arachnidlabs/reload-pro/pcb/pcb render.png

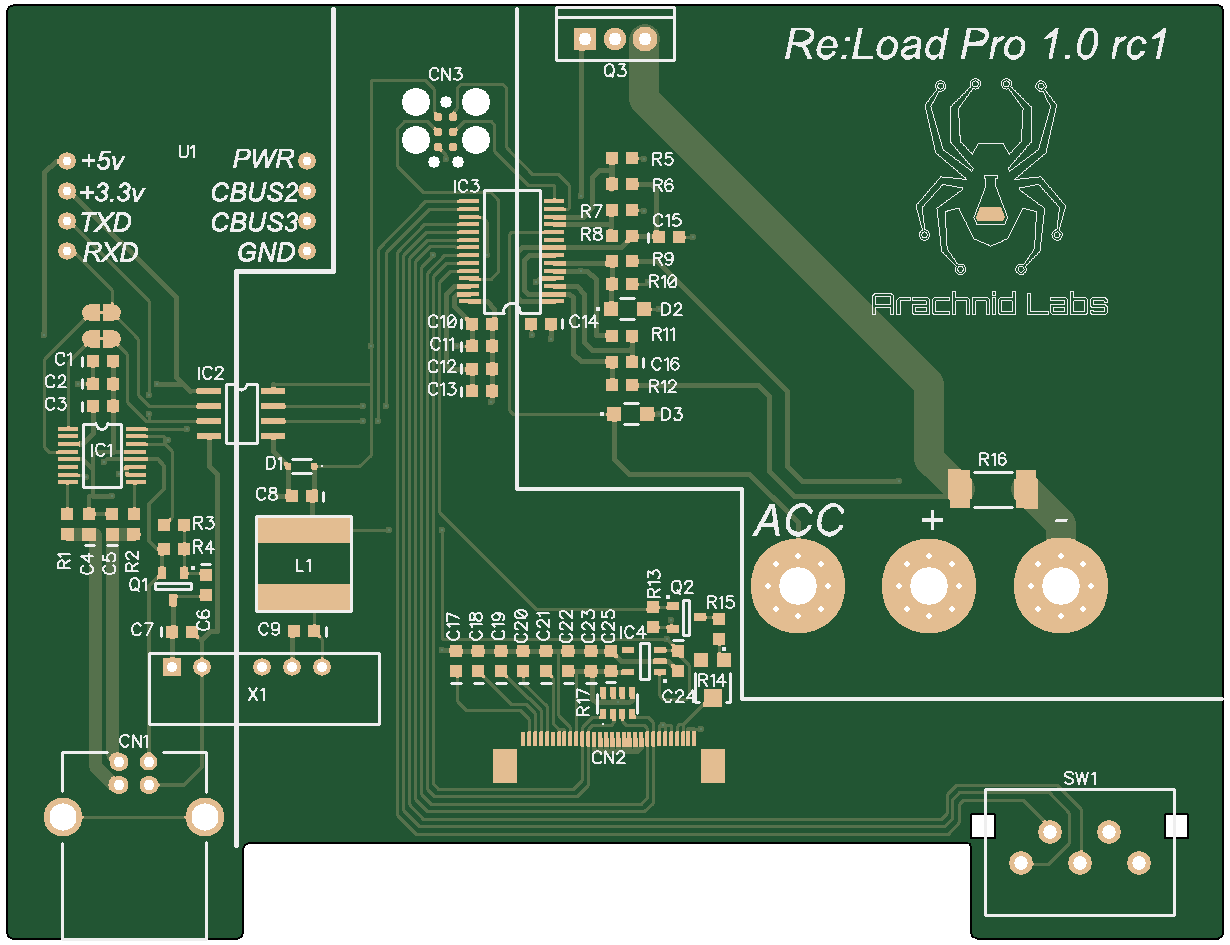
pcb/pcb render.png
