arachnidlabs/reload-pro/models/Fan Plate.dxf

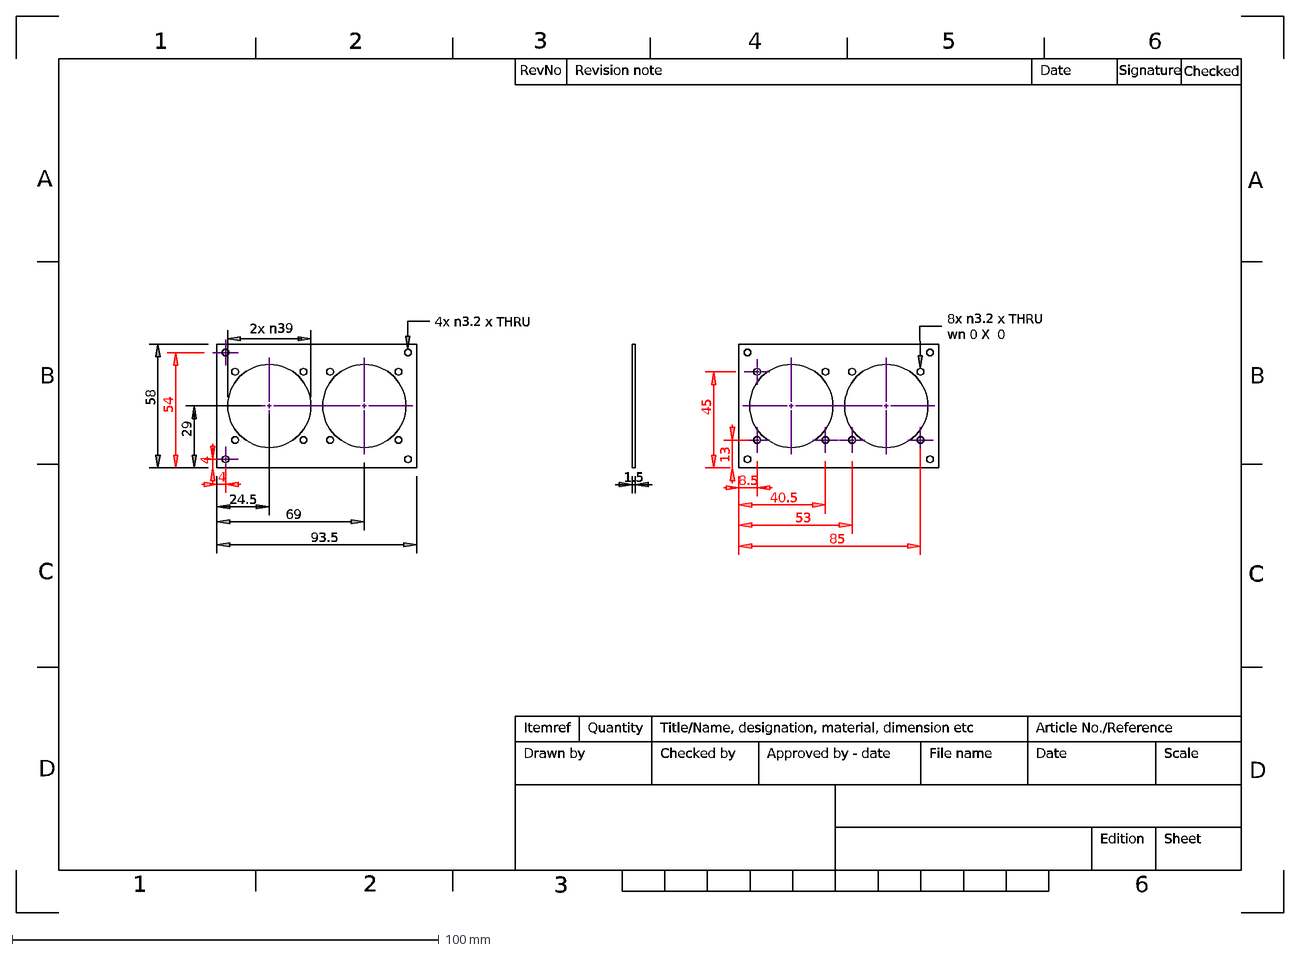
[picture p2: CAD file, 2015-01-16]
models/Fan Plate.dxf
4
29
54
58
24.5
69
93.5
1.5
8.5
40.5
53
85
13
45
1
Approved by - date
5
C
Edition
6
Date
B
3
Scale
A
D
File name
Sheet
Article No./Reference
Signature
Checked
Itemref
2
Quantity
Title/Name, designation, material, dimension etc
Revision note
Drawn by
RevNo
Checked by
