arachnidlabs/reload-pro/pcb/board outline.dxf

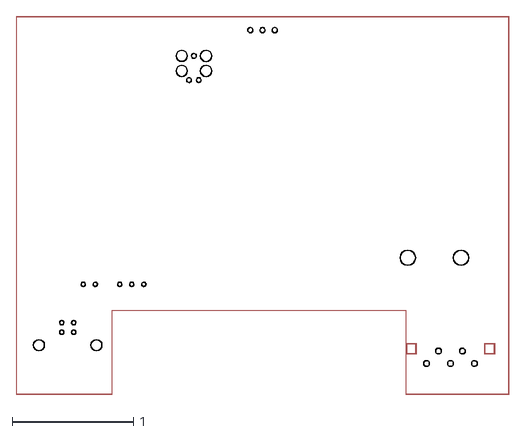
[picture p3: CAD file, 2014-01-12]
pcb/board outline.dxf
4.06 x 3.12
