arachnidlabs/reload-pro/models/AEH087.dxf

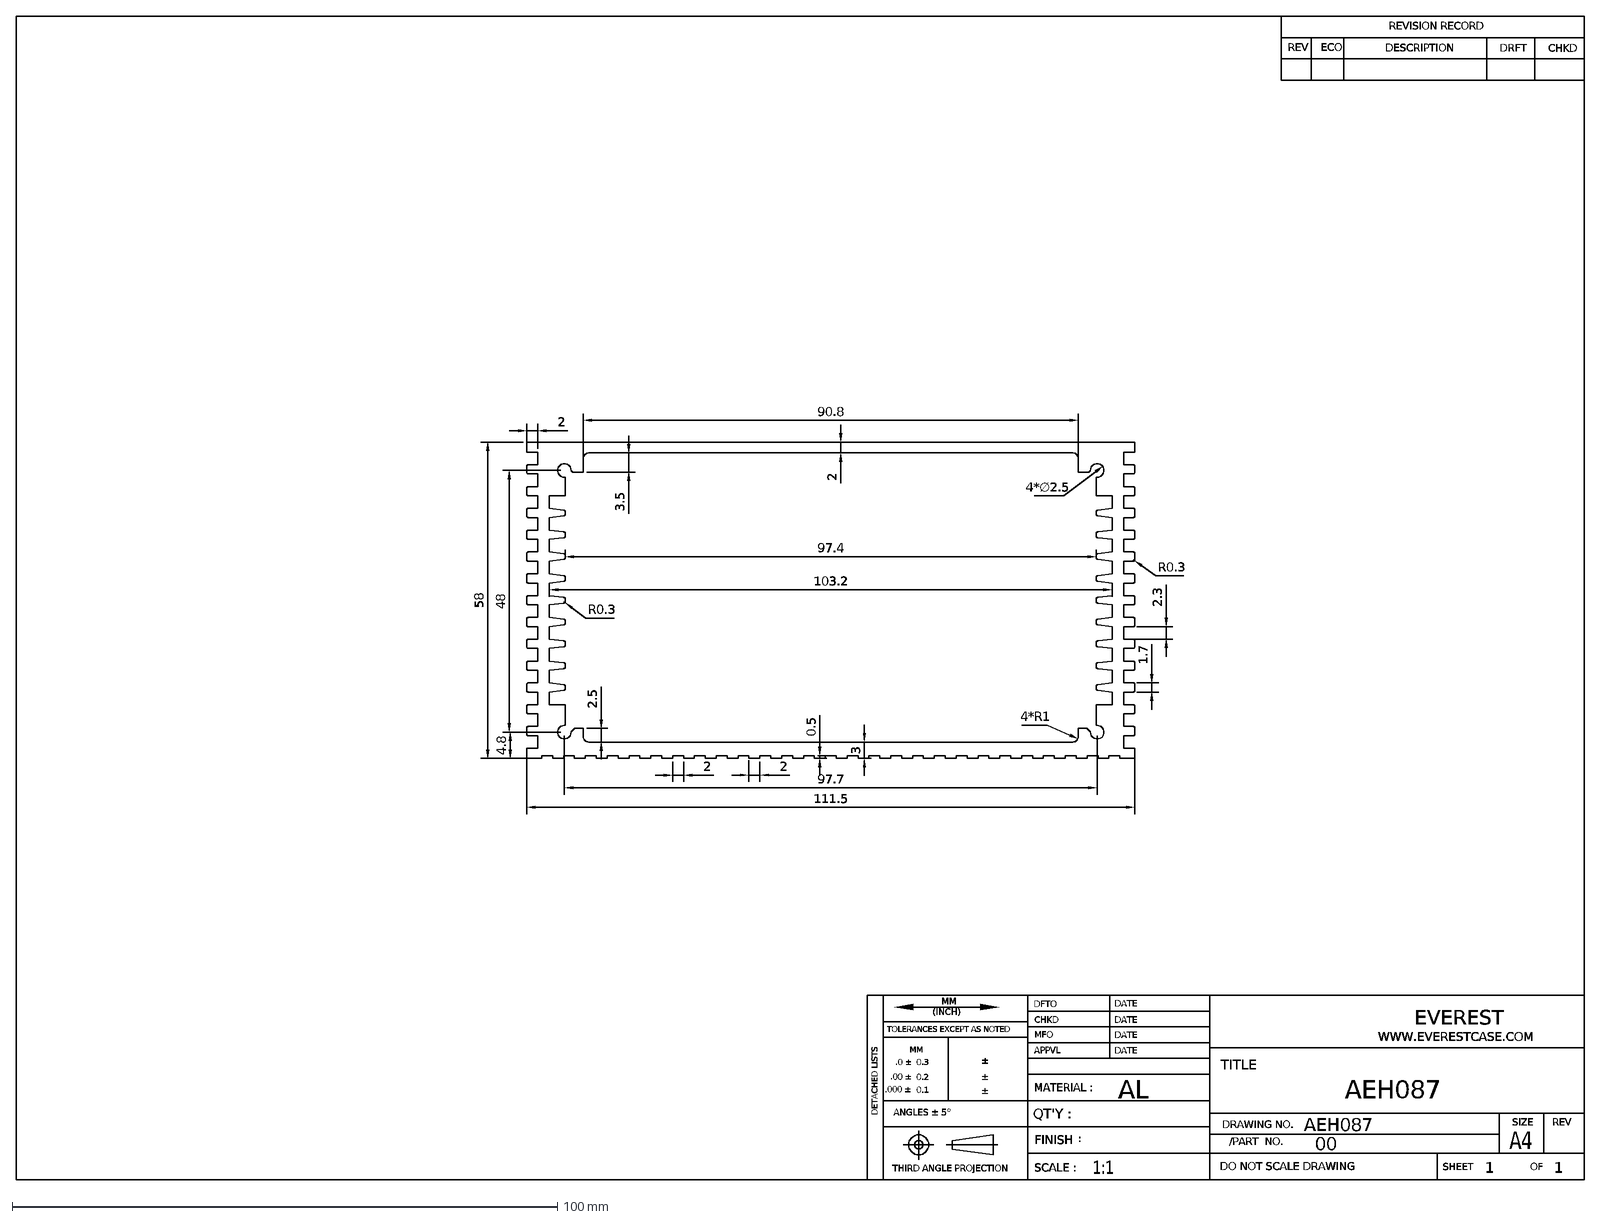
[picture p4: CAD file, 2014-05-03]
models/AEH087.dxf
ECO
REV
DESCRIPTION
CHKD
DRFT
REVISION RECORD
SIZE
A4
DATE
AEH087
00
TITLE
AL
/PART NO.
DRAWING NO.
EVEREST
WWW.EVERESTCASE.COM
SHEET
OF
DO NOT SCALE DRAWING
MM
DFTO
±
MATERIAL :
QT'Y :
APPVL
MFO
FINISH
:
.00 ±
0.2
DETACHED LISTS
0.1
.000 ±
0.3
.0 ±
ANGLES ± 5°
TOLERANCES EXCEPT AS NOTED
(INCH)
THIRD ANGLE PROJECTION
SCALE :
2
97.7
111.5
4*R1
4*∅2.5
R0.3
0.5
3
1.7
2.3
4.8
48
58
90.8
3.5
2.5
97.4
103.2
