arachnidlabs/reload-pro/models/Reload Pro Heatsink.dxf

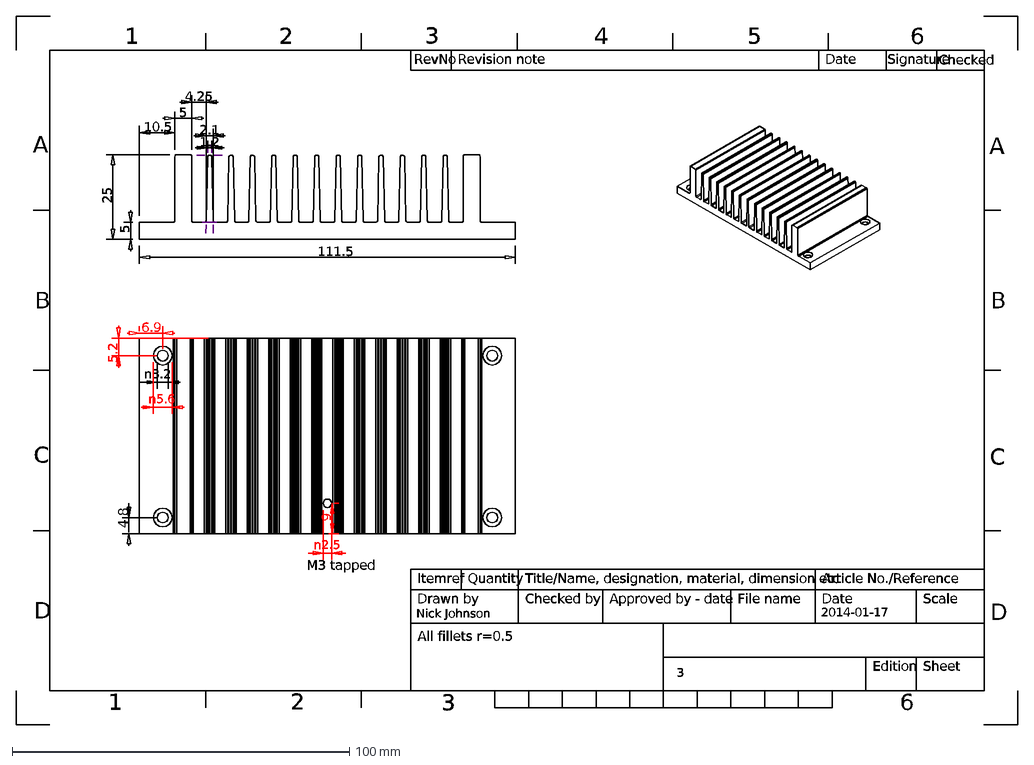
[picture p5: CAD file, 2014-01-18]
models/Reload Pro Heatsink.dxf
111.5
5
10.5
1.2
4.25
2.1
25
6.9
5.2
4.8
9
M3 tapped
3
Edition
Title/Name, designation, material, dimension etc
A
Quantity
Itemref
Checked
Scale
Checked by
B
Drawn by
Article No./Reference
Approved by - date
Revision note
Sheet
Date
6
1
C
2014-01-17
Signature
2
D
File name
RevNo
Nick Johnson
4
All fillets r=0.5
