arachnidlabs/reload-pro/models/Front Panel.dxf

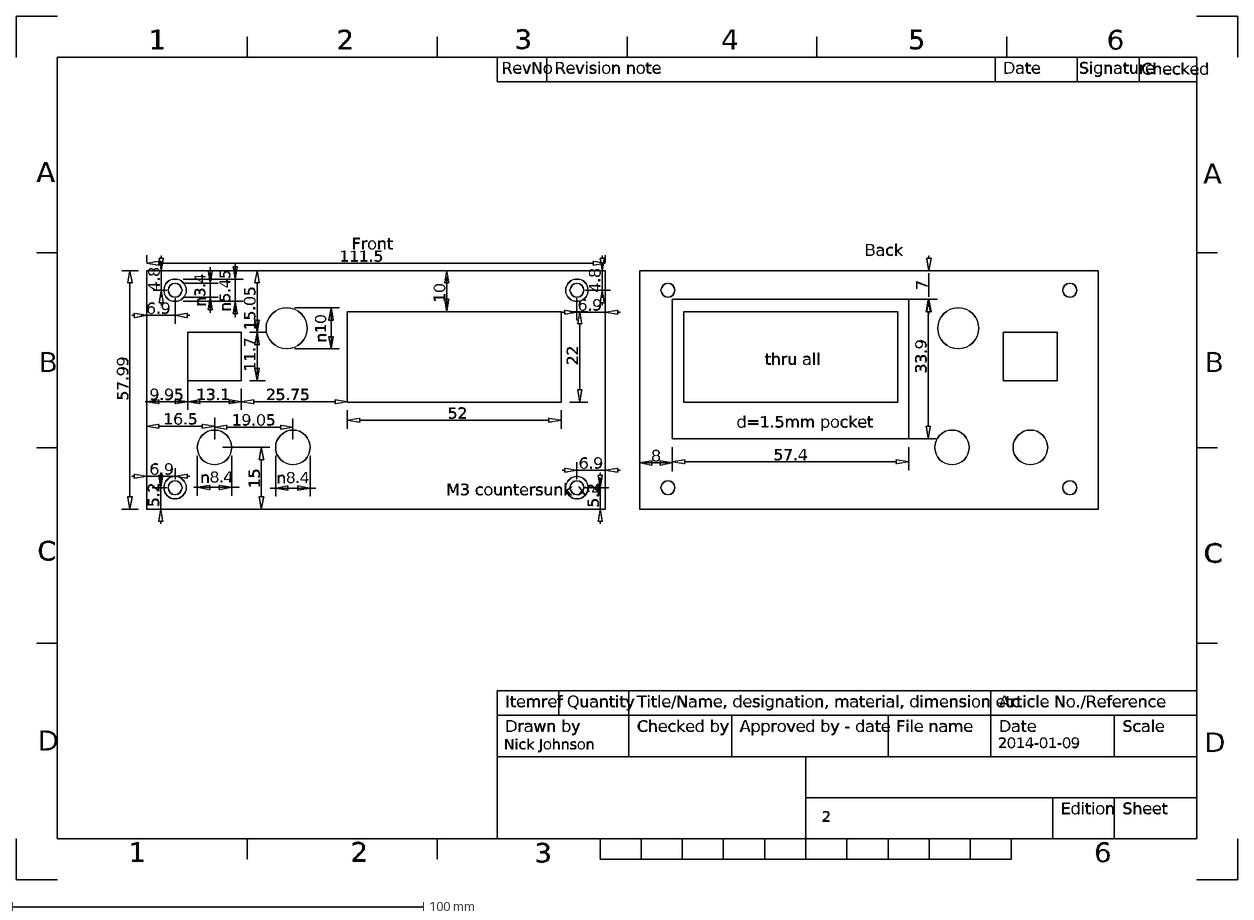
[picture p6: CAD file, 2014-01-12]
models/Front Panel.dxf
11.7
13.1
52
22
6.9
4.8
5.2
9.95
15.05
25.75
10
111.5
57.99
16.5
19.05
15
M3 countersunk x 4
33.9
7
57.4
8
Front
Back
d=1.5mm pocket
thru all
C
Sheet
RevNo
B
1
2
Revision note
3
A
Scale
Nick Johnson
5
D
6
Article No./Reference
Signature
Edition
4
Title/Name, designation, material, dimension etc
Quantity
File name
Drawn by
Itemref
Approved by - date
Checked by
Date
2014-01-09
Checked
