arachnidlabs/reload-pro/(list of files, cad)

Other CAD files:
models/Front Panel.dwg
models/Reload Pro Heatsink.dwg
