arachnidlabs/reload-pro/(threads)

Thread 73 (2014-11-16):

Release 1.9 makes screen flicker

bartv, 2014-11-16:
My screen flickers constantly after flashing version 1.9 (upgrade from 1.6). I tried to downgrade to 1.8 but cyflash will not let me:

[bart@tripel tmp]$ python -m cyflash --serial /dev/ttyUSB0 Reload\ Pro\ v1.8.cyacd
Initialising bootloader.
Silicon ID 0x04a61193, revision 17.
Array 0: first row 22, last row 255.
Device application_id 0, version 265.
Traceback (most recent call last):
  File "/usr/lib64/python2.7/runpy.py", line 162, in _run_module_as_main
    "__main__", fname, loader, pkg_name)
  File "/usr/lib64/python2.7/runpy.py", line 72, in _run_code
    exec code in run_globals
  File "/usr/lib/python2.7/site-packages/cyflash/__main__.py", line 2, in <module>
    bootload.main()
  File "/usr/lib/python2.7/site-packages/cyflash/bootload.py", line 217, in main
    "Device app ID %d is different from local app ID %d. Flash anyway? (Y/N)"))
  File "/usr/lib/python2.7/site-packages/cyflash/bootload.py", line 123, in bootload
    self.check_metadata(data, downgrade, newapp)
  File "/usr/lib/python2.7/site-packages/cyflash/bootload.py", line 172, in check_metadata
    if not downgrade(metadata.app_version, local_metadata.app_version):
TypeError: 'NoneType' object is not callable

I tried to reset the device to factory defaults without results.

I recording of the behavior:
https://dl.dropboxusercontent.com/u/3546611/VID_20141116_215231.mp4

danielbriggs, 2015-02-03:
Having upgraded from V1.3 to V1.9 today, my unit suffers the same flickering.

bartv, 2020-08-08:
This is fixed with the 1.11 firmware.

Closed 2020-08-08.

Thread 80 (2015-01-08):

Positive input is connected to the case of instrument

raivisr, 2015-01-08:
It should be stressed in manual that positive input is shorted to the instrument case via tab on BTS141 and I would suggest that instructions are provided on how to install insulator between power transistor and heatsink for people who are willing to sacrifice power rating for isolation.

limpkin, 2015-01-08:
A few side notes to make users understand how **serious** this issue is.
Users having their power supplies with the DC GND connected to the mains earth may be electrically shocked (60V is starting to be very serious). If bare feet, the user may loop the load high side voltage (up to 60V) to GND through their home's earth.

Arachnid, 2015-01-08:
You're right that this needs to be corrected, and emphasised in the manual. I'll get on it.

60V is still under the low voltage directive lower limit of 75V; in theory it's not dangerous to users, though of course any voltage can be dangerous in the right conditions.

limpkin, 2015-01-08:
Answers from http://electronics.stackexchange.com/questions/19103/how-much-voltage-is-dangerous indicate otherwise.

Arachnid, 2015-01-08:
I really hope that nobody's operating the R:LP or any other electrical equipment while standing in a bath of conductive liquid. However, point taken that it's a potential hazard if not notified.

Here's my current plan:
 - Post an advisory on Kickstarter, by email to purchasers, and on my site with a description of the issue, its hazards, and how to remediate it.
 - Offer insulation kits and instructions to remedy the issue for free (postage incl) to anyone who's previously purchased the R:LP
 - Have insulation kits added to unsold stock of the R:LP

Does this sound appropriate?

raivisr, 2015-01-08:
I suggest that you measure impact of couple of most popular insulators (mica and silicone rubber?) on power dissipation capability of the RL:P, and advise users of what they gain and what they lose if they do the mod.

electrokean, 2015-01-08:
This sounds like a good strategy to me Nick.  Anyone working with voltages over 30V should be taking extra care anyway, but I agree most people would not think that the case would be connected to the positive terminal.

Another factor to consider is the anodising/paintwork provides a level of insulation.  In fact I cannot measure a short via the outside of the case on my production unit, except where the silver screw is visible between the heatsink fins (not even in the tapped holes on the heatsink meant for mounting the fan kit).  On my early "first in line" unit, I can measure it because of a scratch, and the bare metal bracket of my prototype fan kit.  Mind you the breakdown voltage of that "insulation" could be less than 60V, and all it takes is a scratch in the suface... so installing an insulator is the correct action for sure.

It is important that people understand the correct way to insulate the TO220 - adding the insulator isn't effective unless a bush is correctly installed on the screw.  I've seen people make that mistake and blow FET's a few times before realising (no, it wasn't me).

I also note that the BTS141 datasheet doesn't actually mention the tab connection to pin 2.  Grrrr!

raivisr, 2016-02-08:
I think this has been resolved a while ago and can be closed as such.

Closed 2016-02-08.

Thread 81 (2015-01-28):

Feature Request: Internal Resistance measuring (batteries)

niokofast, 2015-01-28:
As "discussed" in the comments.
A feature to measure internal resistance of batteries. This would make the re:load a very handy battery selecting tool.

loopingzzz, 2015-01-30:
That would be good.

Closed 2016-11-29.

Thread 82 (2015-02-03):

Encoder Push Button Debounce

danielbriggs, 2015-02-03:
Hi,
I've upgraded to V1.9 today from V1.3 and the unit still does not always handle the button debouncing correctly when selection options from the menu. It's not as bad as V1.3, but still occurs. I noticed this was "fixed" in V1.9 release, could it be looked at again?

Thanks,
Dan

Closed 2015-03-28.

Thread 84 (2015-02-08):

Set current <1A off after calibration

danielbriggs, 2015-02-08:
Hi there,
I've installed V1.9 on my Reload:Pro and performed the calibration several times as per the instruction manual with a Rigol DP832 power supply; the supply was setup correctly and did not go into current limiting mode at any point during calibration or operation.

The calibration is off by quite a considerable amount on <1A settings, and no current flows until around 240mA set current. For me, the 0-1A range is most useful so I'm keen to get this working if anyone has any pointers?
Calibration 1-3A range is really good, with no issues.

I graphed the results:
http://danielbriggs.co.uk/images/ReloadPro_Calibration.PNG

I did some searching around and found mention of a possible fix in V1.9.1, but couldn't find anywhere to download this, V1.9 seemed the latest firmware available to download (some 4 months ago).

Any pointers?

electrokean, 2015-02-08:
Try the manual offset calibration process as noted here:
https://github.com/arachnidlabs/reload-pro/issues/74
and here:
https://github.com/arachnidlabs/reload-pro/issues/28#issuecomment-58252206
Should make a big difference to those sub 1A set points.

danielbriggs, 2015-03-02:
Hi there,
Thanks for that, I finally got around to testing it out again.

The CAL O was set to 12.
The response improved gradually the more I dropped this value.
It's now set to "0" and set point matches actual current (+/- 5mA) down to 180mA. 0-180mA the calibration is still way off.
There is also +/- 20mA of oscillation at a lot of the set points up to 3A which I've tested.

Any ideas to improve stability + current response <180mA?
The range 0-500mA is the main range I would like to be using.

Best Regards,
Dan

electrokean, 2015-03-04:
Hmmm... on both my units adjusting the Cal O value gave me quite good calibration down to about 20mA.  Below 50mA and above 50W I have other equipment that I'd use.
I haven't noticed oscillation on my units, but I also don't tend to run them at low currents or monitor them closely for any length of time.  Nick has mentioned in the issue 85 thread that oscillation at low currents may be due to the background software calibration loop.

danielbriggs, 2015-03-30:
I've just updated the unit to V1.10 and re-ran the calibration (with no reset) and it's very much improved over the full range. I noticed an extra calibration step which might have been added since last time.
After calibration, small errors of around +5mA are observed up to 0.5A, and -5mA on higher ranges 1-3A. This is within spec, so I'm now very happy. Thanks!

Closed 2015-03-30.

Thread 85 (2015-02-11):

Pulsing current draw

tzanetos, 2015-02-11:
I just set up my reload pro from the original kickstarter today. I downloaded the latest firmware and installed the fankit. First time powering on the screen flashed and then went blank but after re-seating the ribbon cable that part worked fine.

The main problem that im seeing is a continuous pulsing of current of the reload pro instead of a steady current draw. My setup is as follows:
-Reload Pro running Reload Pro v1.9.cyacd
-9V battery connected to the red and black leads. 8.17V with no load
-20mA selected as the current setpoint.
-Agilent MSO3000 series oscope connected to the battery leads in parallel with the reload pro.

The reload pro current current and voltage are jumping all over the place instead of converging to a single value.

Below is my oscilloscope capture of the phenomenon. Note the time scale and voltage range.

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

Arachnid, 2015-02-11:
This is almost certainly an issue with the software loop designed to match actual to measured current. Do you have access to a copy of Windows where you can install PSoC creator? If not, I can provide a custom build of the firmware to test this out.

tzanetos, 2015-02-11:
No not readily available.

What is the blue port for?
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

Arachnid, 2015-02-11:
The blue port is an accessory port, currently unused.

I'll put together a build that has this feature disabled (or at least toggleable) this evening. Can you confirm that you get less variation (proportionally) at higher currents?

tzanetos, 2015-02-11:
Going pat ~180mA appears to create a dead short, so I only used small
currents at first.

Part of my problem is that my DC power supplies are out of commisiom, but I
can use alkaline and lipo (3s 2600mAh) batteries for now
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

tzanetos, 2015-02-12:
Any update?

On Wed, Feb 11, 2015 at 9:25 AM, Theodore Tzanetos <tzanetos.t@gmail.com>
wrote:

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

Arachnid, 2015-02-14:
Sorry for the delay; please try flashing the CYACD file here: https://drive.google.com/file/d/0B_iKMAYU3t1LNWh1RFdWRHVoYnM/view?usp=sharing

You may see offset error between the set and actual current with this test firmware, but it should allow us to check that the oscillations are eliminated.

tzanetos, 2015-03-06:
Yes this seemed to fix the oscillations. I see more of an offset  at lower
currents (<500mA). What is the long term fix/solution for this problem, and
why was mine defective. Have others experienced the same?

Also i registered to receive the thermal insulation kit. When will that be
sent out?

Thanks,
-Teddy

On Sat, Feb 14, 2015 at 6:37 AM, Nick Johnson <notifications@github.com>
wrote:

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

brearto2, 2015-09-22:
@Arachnid
Is there a permanent fix for this issue?

I just downgraded from firmware version 1.11 to fix this issue (using the firmware linked above) because I was getting the same issue. My multimeter was reading upwards of 4A (no oscope available) before my power supply would shutoff.

Thread 88 (2015-03-28):

Display of ohms when current set to zero

raivisr, 2015-03-28:
Sorry for blurrycam, but this is how it looks if display is set tho show ohms and current is set to zero. Probably because of noise in current measurement it jumps between no resistance and something small.
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

knarfS, 2015-03-30:
I already posted nearly the same bug plus some others related to the Ohms readout. See #72

raivisr, 2015-03-30:
Duplicate of #72

Closed 2015-03-30.

Thread 89 (2015-04-12):

Left Hand Voltage Display garbage

nealzip, 2015-04-12:
Running 1.10 code and right hand voltage having display corruption sometimes.

Display does correct it self given enough time. Maybe corrupt after adjusting menu???

Arachnid, 2015-04-13:
What readouts are you selecting for the small displays when this happens?

nealzip, 2015-04-13:
I had Voltage on Left and Total Current on the right AMPs on top.
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

Arachnid, 2015-04-13:
Duplicate of #17 .

Closed 2015-04-13.

Thread 90 (2015-08-31):

Current does not drop to 0 when selecting 0mA after weak source is overpowered

malind, 2015-08-31:
Under certain conditions the reload does not drop the load to 0 even when 0mA is selected, not until it is either restarted or the source delivers a bit of extra current. This is a problem for weak sources that can't provide any substantial start-current. I have had issues with this while testing a weak solar panel (4W panel on a cloudy day) and a usb "power pack".

Synthetic repro:
Connect a 7v 10mA source
Power up the reload
See that it reads 7v 0mA
Select 20mA
See that the source is overloaded, reading 0v
Select 0mA
The weak loads won't recover, and an ampere meter in series still reads ~10mA.
Restart the reload, the load recovers.

The expected behavior would be that the 0mA setting behaves the same as when the reload is restarted. Note that the solar panel test case seemed to require quite a bit more than 10mA to recover at the 0mA setting.

I use firmware 1.11 and I tried re-calibrating it twice.

Thread 94 (2016-10-12):

Add BOM to PCB folder

sthung, 2016-10-12:
Add a bill of materials to the pcb folder

Solarbotics, 2020-02-27:
A BOM would be nice. My rotary encoder _seems_ to have died, and before I go to replacing the IC, I'd like to get just swap the encoder out. What model is this?

Thread 95 (2016-11-24):

Low Flash Space

Ralim, 2016-11-24:
Hi,
As I'm sure that you are aware, there is very very little flash space left in the MCU.
I have started adding code for a simple (but hopefully useful) measurement for battery internal resistance.

I'm wondering if you have any ideas at the moment of where to attack to gain extra room to fit this ?
Currently, I have disabled the startup splash screen in order to be able to test the method.

Open to any ideas?
If not I could go for a trawl to try and clean up and gain some room...

Thanks,
Ralim

Arachnid, 2016-11-26:
I'm not aware of any places we can easily save space, though there doubtless are some.

For debugging, I generally switch to the debug build (which is larger) but disable the splash screen - so the end result is about the same. I'd rather not disable the splash screen on the production firmware, if possible.

Closed 2016-12-21.

Thread 99 (2021-01-31):

Reload-pro repair information and example provided in this issue.

royfranz, 2021-01-31:
Not really an issue, I'm using this to present what I learned from repairing mine, and to post some files that Nick provided that were helpful.

Recently my Reload:pro failed when I hooked it up to an 18v battery, and I have no idea what cause this.  I did see some strange behavior as I was setting it up, as it would be detected and then disconnect over USB on my computer, and I could only get it work on certain ports.  I think this may be related to the large current draw that I only noticed after the failure.

After the failure, the unit was completely dead, and would not turn on.  On my second inspection, I found that the sense resistor had visible damage - it let the smoke out on the underside.  While debugging it I found that it was drawing a lot of current over the USB, enough to get the 5v dc-dc converter used for isolation to smoke.  After removing a few of the smaller components, it looked like the MCU was causing the short.  It also looked like the main load FET and one of the protection diodes was also damaged.

I replaced the following parts:

* MCU
* Main load FET  (maybe not direct replacement, see issue below)
* sense resistor
* protection diodes
* zener diode on DC/DC converter  (I don't think this was damaged, but I had removed it while debugging the power/ground short and replaced it with a new one while I was at it.
* DC/DC converter
(I ordered but did not use the opto-isolator chip, as the serial communication worked after I replaced the MCU.)
(compatible displays are also still readily available for about $15 - I ended up getting one due to installing the old 0.11 firmware by accident and the display not working with that.)

I used the CY8CKIT-059￼ to reprogram the new MCU in circuit, using the 1.10 hex files from github.  This was quite easy to do after installing the rather large software package (Windows required.)  I simply programmed the bootloader hex and then the firmware hex.

After this my reload pro is now working again, but there are a couple of issues to be aware of:
* I was unable to build the firmware with the latest code - I got an error of being out of ROM space and other size violations.  I am running the 1.10 code, which is the latest hex file in github, but not the latest code overall.
* When calibrating, the unit wanted to draw 4 amps instead of 2 as described in the manual.  Calibration will not work unless you can meet this current draw at a reasonable voltage.  If you calibrate it with a current limiting PS that is at its current limit and very low voltage, the calibration will be way off.  It took me several tries to get it calibrated properly due to this.  I don't know why this is - my guess is that it could be due to the load FET being not quite what is expected, and that fixed control levels are used during calibration that cause this to be off.

Here is the BOM, schematic, and dch/dip (layout?) files that Nick provided to help me debug it - thank you Nick for your help getting my Reload:pro fixed!  I have also included an image of my digikey order.

[Reload Pro Schematic.pdf](https://github.com/arachnidlabs/reload-pro/files/5900958/Reload.Pro.Schematic.pdf)
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
[reload-pro-dch-dip.zip](https://github.com/arachnidlabs/reload-pro/files/5900968/reload-pro-dch-dip.zip)
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

Thread 100 (2023-04-02):

Lack of stability for the step response testing

Plinsboorg, 2023-04-02:
I tried using Re:load Pro for the power supply step response testing, and I found that it's inappropriate for such testing. At least in my case.

This is the expected step response oscilloscope picture:
- Power supply under test voltage in yellow (AC mode)
- Load current (created by the electronic load) in purple.
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

And this is how the same test looks with Re:load Pro :
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

You can see that the load current is not stable during the load turn-on.
My test conditions are the following:
- DUT voltage 5V
- Knob long press is used to turn on/off the load
- current setpoint is 100mA
- A USB power supply is used. No serial commands used

I know that the project is dead but I still leave it here for the possible next revision of this wonderful project.
I deeply appreciate the work of the authors.

Thread 101 (2023-12-11):

Replacement model for BTS141 FET?

DidierA, 2023-12-11:
Hi,
I have broken the legs of the BTS141 FET. I searched for replacement units, but it seems this model is not made anymore. Is there another model that I can replace it with?

Closed 2023-12-13.
