arachnidlabs/reload-pro/(list of files, drawings)

Other design files:
pcb/fan expansion.dch
pcb/fan expansion.dip
pcb/reload pro .dip
pcb/reload pro.dch
