arachnidlabs/reload-pro/firmware/Reload Pro.cydsn/splashscreen.c

#include "splashscreen.h"

const uint8 splashscreen_data[] = {
    // 0-299: Page 0
    0x01, 0x00, 0x00, 0xE0, 0x07, 0x00, 0x02, 0xE0, 0x00, 0xE0,
    0xA0, 0x00, 0x00, 0x60, 0xE0, 0x10, 0x00, 0x09, 0xA0, 0x60,
    0xE0, 0xC0, 0xE0, 0xE0, 0xC0, 0x80, 0xE0, 0xC0, 0xE0, 0x00,
    0x3D, 0x03, 0x80, 0x00, 0x80, 0x80, 0x60, 0x03, 0xE0, 0x0A,
    0x00, 0x20, 0x1A, 0x40, 0x20, 0x80, 0x00, 0x40, 0x0D, 0x80,
    0x00, 0x04, 0x00, 0x00, 0xF0, 0x00, 0xF0, 0x40, 0x00, 0x02,
    0xE0, 0xF0, 0xF0, 0x80, 0x1B, 0xC0, 0x00, 0x20, 0x23, 0x20,
    0x33, 0xE0, 0x10, 0x00, 0x20, 0x1B, 0x40, 0x23, 0x40, 0x03,
    0xE0, 0x10, 0x23, 0x60, 0x00, 0x40, 0x46, 0x20, 0x01, 0x60,
    0x00, 0x40, 0x08, 0x60, 0x14, 0xE0, 0x08, 0x00, 0x40, 0x7F,
    0x40, 0x00, 0x40, 0x8F, 0xE0, 0x0D, 0x00, 0xE1, 0x1B, 0x13,
    0x01, 0x60, 0x60, 0x21, 0x11, 0x60, 0x01, 0x02, 0x00, 0x00,
    0xC0, 0xE1, 0x02, 0x43, 0x00, 0xA0, 0x20, 0x19, 0xE0, 0x0F,
    0x00, 0xE1, 0x05, 0x47, 0x01, 0xC0, 0x80, 0x41, 0x54, 0x00,
    0xC0, 0x21, 0x77, 0x20, 0x02, 0xE0, 0x10, 0x00, 0x00, 0xE0,
    0x21, 0x7B, 0x20, 0x67, 0x20, 0x2B, 0xE0, 0x0A, 0xAB, 0x20,
    0xDB, 0x00, 0x40, 0x20, 0x1D, 0x11, 0x60, 0xE0, 0x30, 0x64,
    0x7A, 0x74, 0x1A, 0x0C, 0x07, 0x1E, 0x0A, 0x01, 0x08, 0x1A,
    0x04, 0x0A, 0x0E, 0x0E, 0xE0, 0x01, 0x2B, 0x41, 0x05, 0x04,
    0x00, 0xC0, 0xC0, 0xC0, 0xA0, 0x20, 0x26, 0x18, 0x50, 0xE0,
    0x30, 0x70, 0x28, 0x30, 0x18, 0x0A, 0x14, 0x3C, 0x0F, 0x04,
    0x00, 0x0F, 0x01, 0x0C, 0x05, 0x0D, 0x06, 0x01, 0x03, 0x0F,
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
    0x80, 0x00, 0xE0, 0x9F, 0x98, 0xFE, 0x40, 0x77, 0x03, 0x0F,
    0x71, 0x96, 0x3F, 0xE0, 0x00, 0x16, 0x12, 0x00, 0x00, 0x04,
    0x0E, 0xF0, 0x04, 0xFE, 0x09, 0xFA, 0x13, 0xFB, 0x0A, 0x05,
    0x07, 0x0F, 0x00, 0x04, 0x02, 0x0C,
    // 1813-1912: Page 7
    0x02, 0x00, 0x01, 0x00, 0xE0, 0xFF, 0x01, 0xE0, 0x11, 0x01,
    0x00, 0x7F, 0xA0, 0x01, 0x00, 0x60, 0xE0, 0xAD, 0x01, 0x1F,
    0x01, 0x60, 0x00, 0x61, 0x03, 0x61, 0x01, 0x63, 0x06, 0x63,
    0x07, 0x67, 0x0C, 0x64, 0x2A, 0x7E, 0x78, 0x10, 0x20, 0x78,
    0x40, 0x78, 0x90, 0x70, 0x70, 0x00, 0x78, 0x70, 0x00, 0x20,
    0x10, 0x60, 0x00, 0x00, 0xE0, 0x32, 0x00, 0x1B, 0x20, 0x10,
    0x40, 0x70, 0x70, 0x8F, 0xD8, 0xFF, 0x58, 0xE7, 0xB0, 0xFF,
    0x38, 0x40, 0x1C, 0x78, 0x0C, 0x06, 0x06, 0x0E, 0x03, 0x06,
    0x07, 0x07, 0x01, 0x03, 0x01, 0x03, 0x61, 0x51, 0xE0, 0x07,
    0x00, 0x00, 0xFF, 0xA0, 0x01, 0x60, 0x00, 0x01, 0x00, 0x00,
};

const int16 splashscreen_indexes[] = {0, 300, 625, 981, 1314, 1488, 1657, 1813, 1913};
