arachnidlabs/reload-pro/firmware/Reload Pro.cydsn/calibrate.h

#ifndef CALIBRATE_H
#define CALIBRATE_H
	
#include "config.h"

typedef void (*progress_callback_t)(int,int);
void calibrate_offsets(settings_t *newsettings);
void calibrate_voltage(settings_t *newsettings, int microvolts);
void calibrate_current(settings_t *newsettings, int microamps);
void calibrate_opamp_offset_trim(settings_t *newsettings, int microamps, progress_callback_t progress_callback);
void calibrate_dacs(settings_t *newsettings, int microamps);
void set_opamp_offset_trim(settings_t *newsettings, int trim);

#define MAX_OA_OFFSET_STEPS 64

#endif
