arachnidlabs/reload-pro/(commit log)

2013-12-27 Added splashscreen, rewrite of how display images are generated, added ADC reading task
2013-12-27 Implement calibration procedure, other tweaks
2013-12-28 Added support for manual current range selection
2013-12-29 Fix menu system for multi-page menus with headers
    [ui.c]
2013-12-29 Have a 'do nothing' func instead of a special case for NULL
2014-01-05 Changes to debug compile for better code size; production changes to PCB.
    [reload pro .dip, reload pro.dch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]
2014-01-05 Switched from a moving average to IIR filter, reducing memory usage and code size
2014-01-05 Added trimpot for backlight
    [reload pro .dip, reload pro.dch]
2014-01-05 Eliminate the ADC task in favor of updating the IIR filter from the ISR
    [reload pro .dip]
2014-01-08 Improvements to PCB layout for screw terminals
    [board outline.dxf, reload pro .dip, reload pro.dch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]
2014-01-08 3D models for enclosures
    [Reload Pro Heatsink.dwg, Reload Pro Heatsink.dxf]
2014-01-12 Updated model and PCB to have encoder on the right
    [Front Panel.dwg, Front Panel.dxf, board outline.dxf, reload pro .dip]
2014-01-18 Updated opamp offset calibration to use internal ADC measurements, and tweaked the rest of the calibration procedure
2014-01-18 New heatsink design
    [Reload Pro Heatsink.dxf]
2014-01-18 PCB tweaks
    [reload pro .dip]
2014-01-19 Refactored PCB for enhanced IDAC instead of multiple ranges
    [reload pro .dip, reload pro.dch]
2014-01-27 Refactored PCB to use new two-IDAC system
    [reload pro .dip, reload pro.dch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]
2014-03-30 Many changes and improvements (too long sincethe last commit\!)
    [reload pro.dch]
2014-04-14 Added PDF version of schematic
2014-04-20 Accessory jack in front panel, and 3.3v reg and pullups for display
    [reload pro.dch]
2014-04-20 Accessory jack pinout
    [reload pro.dch]
2014-04-20 New expansion footprint for USB side
    [reload pro .dip, reload pro.dch]
2014-04-20 More PCB changes; layout tweaks
    [reload pro .dip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]
2014-04-20 Fixed FT230X footprint
    [reload pro .dip, reload pro.dch]
2014-04-20 Tweaks to drawing and PCB
    [reload pro .dip]
2014-04-23 RC2 board: new encoder, added standard SWD header, changed tag-connect to no-legs version
    [reload pro .dip, reload pro.dch]
2014-05-03 New gerbers, updated schematics
    [AEH087.dxf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]
2014-05-05 Final revision of PCB
    [reload pro .dip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]
2014-05-13 Misc model and PCB changes
    [minishift-xyrs.csv, reload pro .dip, reload pro.dch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]
2014-05-31 Updated firmware for PSoC creator 3.0 SP1
    [reload pro.dch]
2014-05-31 Added calibration code in a separate file
2014-06-10 Rewrote calibration routine, and added serial support for it
2014-07-17 Fix calibration routine; wallpaper over menu bug until there's time to fix it
    [Front Panel.dwg, Front Panel.dxf, Reload Pro Heatsink.dwg, Reload Pro Heatsink.dxf]
2014-08-19 Added watchdog timer
2014-08-25 Fixed various bugs that led to maximum current being unexpectedly drawn; misc others
    [ST7528.c, ST7528.h, config.h, main.c, ui.c, utils.c]
2014-08-25 Fix calibration bugs
2014-08-25 Added calibration and testing tool
2014-08-29 Fix a nasty bug with display initialisation
    [ST7528.c]
2014-09-07 Implemented lower voltage cutoff
2014-09-07 Expansion PCB initial design
    [Fan Plate.dxf, fan expansion.dch, fan expansion.dip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]
2014-09-08 Remove files from unrelated projects
    [minishift-xyrs.csv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]
2014-09-16 Changes to fan expansion
    [fan expansion.dch, fan expansion.dip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]
2014-09-22 Massively improved calibration, added software feedback loop
2014-09-28 Added new calibrate functions for reading and setting opamp offset trim
2014-10-05 Added version flag, separated opamp offset and DAC calibration, officially released 1.6
    [fan expansion.dch]
2014-10-07 Fixed what looked like segfault in calibration routines.
    [calibrate.c, calibrate.h]
2014-10-07 Fixed few compiler warnings.
    [ST7528.c, ui.c]
2014-10-07 Updated fan plate drawing
    [Fan Plate.dxf]
2014-10-08 Added calibration progress indicator and fixed arachnidlabs/reload-pro#23
    [calibrate.c, calibrate.h, comms.c, ui.c]
2014-10-09 Added "printf" debug capability with inter-task safeguards in place.
2014-10-09 Added explicit initialization of uart write protection mutex, which no only adds to readability, but also shrinks flash by 8 bytes as compared to implicitly initialized mutex. Moved MAX_RESPONSE_LENG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
2014-10-09 Output current setpoint over serial when adjusted via UI, fixing #19. Also remove obsolete high/low range current setting
    [config.h, ui.c, utils.c]
2014-10-09 Add range checking for current set command fixing #38; fix set responses from UI to be in mA not uA
    [comms.c, config.h, ui.c]
2014-10-09 Make max uart_printf line length 80, and allocate buffer on heap
2014-10-10 Fixed background width on menuitems
    [ui.c]
2014-10-10 Fix issue #39 Overtemp triggers if checked just after an under voltage condition
    [adctask.c]
2014-10-11 Implemented accelerated quadrature decoder, added upper current limit check, implemented a little longer debounce for button.
2014-10-13 Set min current step to 10mA, reduce encoder acceleration threshold to 400ms
2014-10-13 Moved acceleration into current setpoint function so menus aren't accelerated
2014-10-13 Added EXIT option to menus, fixing #21
    [ui.c]
2014-10-13 Reduce display update rate to 2hz from 10hz, addressing #33
2014-10-17 Add a correction factor for voltage based on current usage, fixing #55.
    [adctask.c, config.h]
2014-10-17 Added uvlo command, fixing #22
    [commands.h, comms.c]
2014-10-17 Fix set command to report value when used with 0 arguments, and add uvlo range checking
    [comms.c, config.h]
2014-10-17 Flashing backlight in case of OS error
    [main.c]
2014-10-30 Long button press event
2014-11-09 Start calibration from default settings
2014-11-09 Calibrate voltage and current using adc offsets
2014-11-09 Use only new settings when calibrating
2014-11-09 More digits displayed during calibration
2014-11-09 Disable DAC offset correction during offsets and gains calibration, and do not rely on "set_current"
    [ui.c]
2014-11-09 Adjust calibration values by 1 increments
2014-11-09 Calibration of internal voltage drop
2014-11-09 Dump calibration values
2014-11-13 Move calibration dump in "cal x" command
2014-11-13 Moved voltage_correction_ratio at the end of the struct
2014-11-13 Move calibration settings in own structure
2015-01-16 Fan expansion design files
    [Fan Plate.dxf, fan expansion.dch, fan expansion.dip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]
2015-03-19 Display setpoint while turning knob, then switch back to previous readout.
2015-03-26 Fixed debounce for good
    [ui.c]
2016-02-29 Add printouts for micro mah and wh
2016-11-26 Add battery ISR measurement+cleanup
    Add Battery ISR to Tools menu
    Remove backlight brightness setting as its not used
    Add #ifdef around version as it doesnt work if backlight is off
    cleanup some code indentation
    enable uvlo 0 to disable uvlo
2016-11-29 Correct menu implimentation
    Correct menu implimentation to use the existing structure
    [ui.c]
2016-11-29 Missed a string... Attempt 3
    [ui.c]
2016-12-21 Add clear command to reset the totals for mAh and mWh
    Re-generate serial hash function
    Add small command for running function
    Returns 'ok\r\n' like most commands do
    [commands.h, comms.c]
